nalinally/Rotary_salt_manufacturing_system/(commit log)

2024-02-14 changed readme added excel data file
    [datas.xlsx, データ解析用.xlsx, 塩分濃度.xlsx]
2024-02-17 changed readme and excel
    [塩分濃度.xlsx]
2024-02-22 modified readme
    [塩分濃度から海水量を推定すると飛散の影響を抑制できる.xlsx, 塩分濃度センサ実験.xlsx]
